eclisia/FrogINTHardware/04_Electronique/FrogINT_PCBProto_V1811062154/Export_Illustration_gros_bouton.png

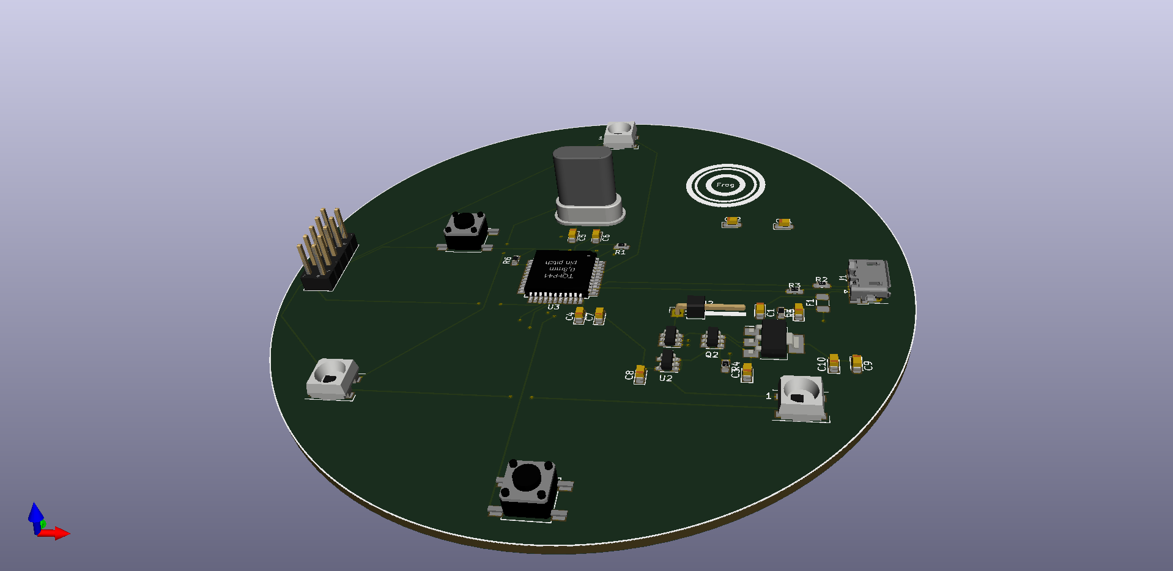
04_Electronique/FrogINT_PCBProto_V1811062154/Export_Illustration_gros_bouton.png
