eclisia/FrogINTHardware/03_Mecanique/FrontFace.png

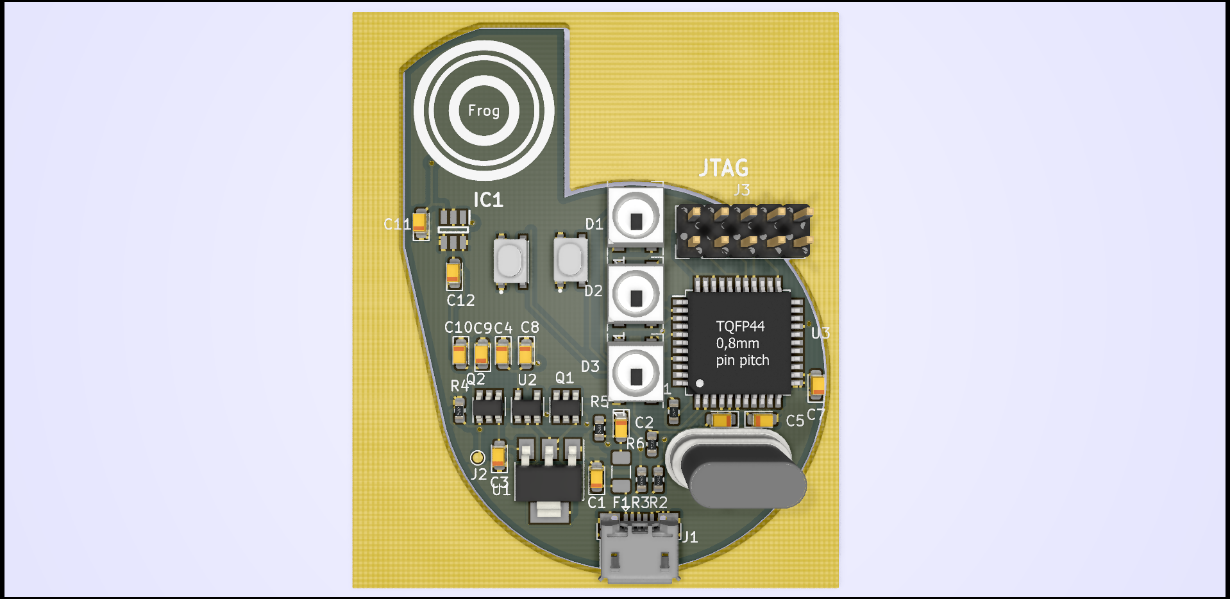
03_Mecanique/FrontFace.png
