eclisia/FrogINTHardware/03_Mecanique/FrontFace_Sans.png

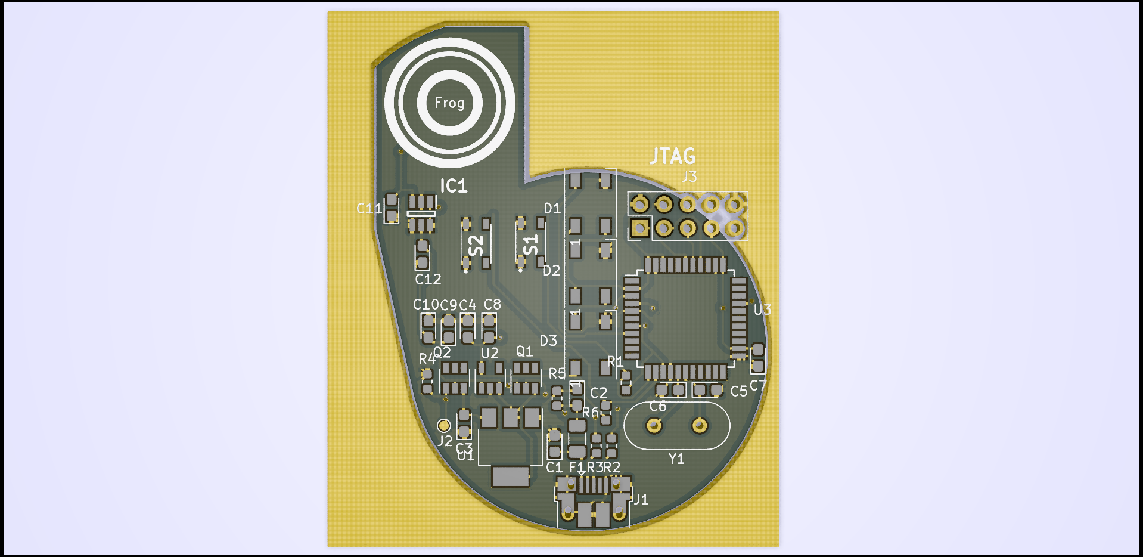
03_Mecanique/FrontFace_Sans.png
