eclisia/FrogINTHardware/03_Mecanique/FrontFace_SVG.png

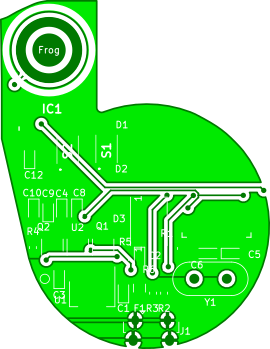
03_Mecanique/FrontFace_SVG.png
