eclisia/FrogINTHardware/04_Electronique/FrogINT_PCBProto_V1811062154/Export_Production_V190118-2315/Illustration_Side2.jpg

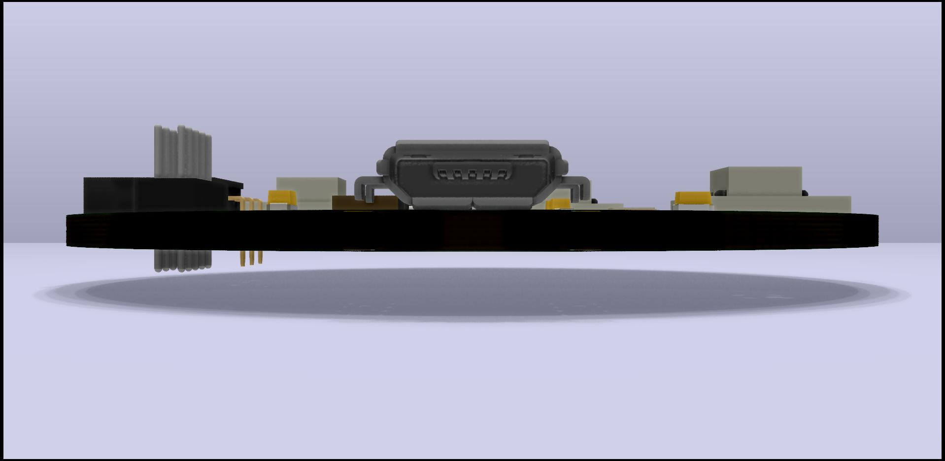
04_Electronique/FrogINT_PCBProto_V1811062154/Export_Production_V190118-2315/Illustration_Side2.jpg
