eclisia/FrogINTHardware/04_Electronique/FrogINT_PCBProto_V1811062154/FrogINT_PCBProto_V1811062154.png

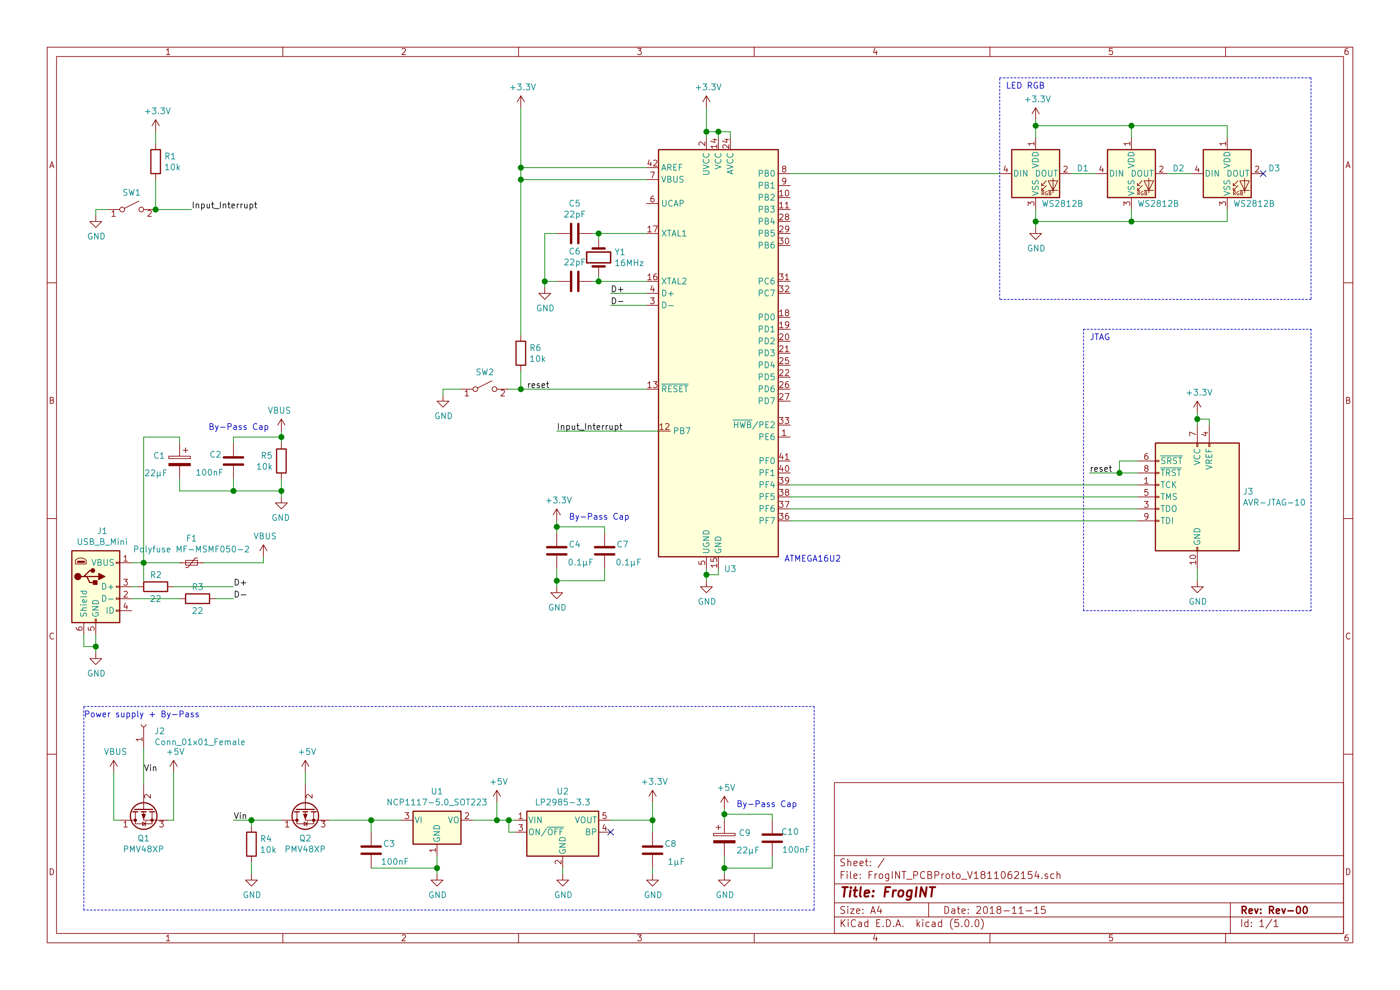
04_Electronique/FrogINT_PCBProto_V1811062154/FrogINT_PCBProto_V1811062154.png
