eclisia/FrogINTHardware/04_Electronique/FrogINT_PCBProto_V1811062154/FrogINT_BOM_V03.xlsx

Sheet: A_Lire
Nouvelle BOM

Sheet: BOM_Format_RS_V3
Version 03 de la BOM
BOM en date du 02/04/2019
BOM issue de la génération via KICAD + fusion avec l'onglet "OLDBOM_format_RS" (de la V2) afin de récupérer les résistances.
Ne sont pas inclus dans cette version :
Tooling pour la réalisation
Valeure différentes de R et C afin de tester le TouchSense
Id | Designator | Package | Quantity | Designation | Réf RadioSpare | Fabricant
1 | G*** | Logo_Thales_Silk_Bottom | 1 | LOGO
2 | G*** | Logo_CCSL_Silk_Bottom | 1 | LOGO
3 | L3,L2,L1 | WS2812-LED_HeatSink | 3 | LED
4 | F1 | FUSC4632X85N | 1 | Polyfuse MF-MSMF050-2 | 647-8156
5 | J1 | 47642-0001_Molex_USB | 1 | USB_B_Mini | 896-7419
6 | Y1 | Crystal_SMD_SeikoEpson_TSX3225-4Pin_3.2x2.5mm_HandSoldering | 1 | XTal TSX-3225 16MHz | 904-7516
7 | C1 | CP_EIA-2012-12_Kemet-R | 1 | 22ÂµF | 838-8083
8 | C2 | CP_EIA-2012-12_Kemet-R | 1 | 100nF | 133-5661
9 | C5,C6,C11 | CP_EIA-2012-12_Kemet-R | 3 | 22pF | 264-4258
10 | J3 | PinSocket_1x03_P2.54mm_Horizontal | 1 | Conn_01x03 | 765-5622
11 | J4 | JTAG_HDRV10W41P127_2X5_676X325X510P | 1 | JTAG | 702-0262P
12 | J5 | TestPoint_THTPad_D2.5mm_Drill1.2mm | 1 | Conn_01x01_Female
13 | R1,R5,R6 | R_0603_1608Metric | 3 | 10k | 120-684
14 | R2,R3 | R_0603_1608Metric | 2 | 22 | 121-889
15 | U3 | TQFP-44_10x10mm_P0.8mm | 1 | ATmega16U4-AU | 177-3649

Sheet: FrogINT_PCBProto_V1811062154
Component,Description,Part,References,Value,Footprint,Quantity Per PCB,Datasheet,Manufacturer_Name,Height,Manufacturer_Part_Number,Mouser Part Number,Mouser Price/Stock,RS Price/Stock,RS Part Number
1,Unpolarized capacitor,C,C4 C7,0.1ÂµF,CP_EIA-2012-12_Kemet-R,2,,,,,,,,
2,Unpolarized capacitor,C,C2 C3 C10 C12,100nF,CP_EIA-2012-12_Kemet-R,4,,,,,,,,
3,Unpolarized capacitor,C,C8,1ÂµF,CP_EIA-2012-12_Kemet-R,1,,,,,,,,
4,Unpolarized capacitor,C,C5 C6 C11,22pF,CP_EIA-2012-12_Kemet-R,3,,,,,,,,
5,Polarized capacitor,CP,C1 C9,22ÂµF,CP_EIA-2012-12_Kemet-R,2,,,,,,,,
6,RGB LED with integrated controller,WS2812B,D1 D2 D3,WS2812B,LED_WS2812B_PLCC4_5.0x5.0mm_P3.2mm,3,https://cdn-shop.adafruit.com/datasheets/WS2812B.pdf,,,,,,,
7,"Resettable fuse, polymeric positive temperature coefficient, small symbol",Polyfuse_Small,F1,Polyfuse MF-MSMF050-2,Fuse_1206_3216Metric,1,,,,,,,,
8,,TTP223-BA6-SamacSys_Parts,IC1,TTP223-BA6,SOT95P285X126-6N,1,https://radiokot.ru/konkursCatDay2014/53/01.pdf,TONTEK,1.26,TTP223-BA6,,,,
9,Atmel 10-pin JTAG connector,AVR-JTAG-10,J3,AVR-JTAG-10,PinHeader_2x05_P2.54mm_Vertical,1,,,,,,,,
10,"Generic connector, single row, 01x01, script generated (kicad-library-utils/schlib/autogen/connector/)",Conn_01x01_Female,J2,Conn_01x01_Female,TestPoint_Pad_D1.0mm,1,,,,,,,,
11,,USB_B_Mini-Connector_FTA,J1,USB_B_Mini,USB_Micro-B_Amphenol_10103594-0001LF_Horizontal,1,,,,,,,,
12,"P-MOSFET transistor, drain/gate/source",Q_PMOS_DGS,Q1 Q2,PMV48XP,SOT-23-6,2,,,,,,,,
13,Resistor,R,R1 R4 R5 R6,10k,R_0603_1608Metric,4,,,,,,,,
14,Resistor,R,R2 R3,22,R_0603_1608Metric,2,,,,,,,,
15,,SKQGAKE010-SamacSys_Parts,S1 S2,SKQGAKE010,SKQGAKE010,2,http://uk.rs-online.com/webdocs/10d6/0900766b810d6137.pdf,ALPS,,SKQGAKE010,688-SKQGAKE010,https://www.mouser.com/Search/Refine.aspx
16,,TouchSense-FTA_FrogINT_library,TS1,TouchSense,CapacitiveTouchSense_Bottom_10mm,1,,,,,,,,
17,,ATmega16U4RC-AU,U3,ATmega16U4RC-AU,TQFP-44_10x10mm_P0.8mm,1,,,,,,,,
18,"150mA 16V Low-noise Low-dropout Regulator With Shutdown, 1.8V output voltage, SOT-23-5",LP2985-3.3,U2,LP2985-3.3,SOT-23-5,1,http://www.ti.com/lit/ds/symlink/lp2985.pdf,,,,,,,
19,"1A Low Dropout regulator, positive, 1.5V fixed output, SOT-223",NCP1117-5.0_SOT223,U1,NCP1117-5.0_SOT223,SOT-223-3_TabPin2,1,http://www.diodes.com/datasheets/AP1117.pdf,,,,,,,
20,Two pin crystal,Crystal,Y1,16MHz,Crystal_HC49-U_Vertical,1,,,,,,,,
Component Groups:,20
Component Count:,35
Fitted Components:,35
Number of PCBs:,1
Total components:,35
Schematic Version:,Rev-00
Schematic Date:,2018-11-15
BoM Date:,21/01/2019 14:16:21
Schematic Source:,D:\Users\taintuf\Documents\04_Travail\04-17_FabLab\01_ConcoursCCSL-Interrompre\02_Electronique\01_Commit_TouchPanel_190116+5a02935\FrogINT_PCBProto_V1811062154\FrogINT_PCBProto_V1811062154.sch
KiCad Version:,Eeschema (5.0.1)-3

Sheet: Mise_en_forme
Component | Description | Part | References | Value | Footprint | Quantity Per PCB | Datasheet | Manufacturer_Name | Height | Manufacturer_Part_Number | Mouser Part Number | Mouser Price/Stock | RS Price/Stock | RS Part Number
1 | Unpolarized capacitor | C | C4 C7 | 0.1ÂµF | CP_EIA-2012-12_Kemet-R | 2
2 | Unpolarized capacitor | C | C2 C3 C10 C12 | 100nF | CP_EIA-2012-12_Kemet-R | 4
3 | Unpolarized capacitor | C | C8 | 1ÂµF | CP_EIA-2012-12_Kemet-R | 1
4 | Unpolarized capacitor | C | C5 C6 C11 | 22pF | CP_EIA-2012-12_Kemet-R | 3
5 | Polarized capacitor | CP | C1 C9 | 22ÂµF | CP_EIA-2012-12_Kemet-R | 2
6 | RGB LED with integrated controller | WS2812B | D1 D2 D3 | WS2812B | LED_WS2812B_PLCC4_5.0x5.0mm_P3.2mm | 3 | https://cdn-shop.adafruit.com/datasheets/WS2812B.pdf
7 | Resettable fuse, polymeric positive temperature coefficient, small symbol | Polyfuse_Small | F1 | Polyfuse MF-MSMF050-2 | Fuse_1206_3216Metric | 1
8 |  | TTP223-BA6-SamacSys_Parts | IC1 | TTP223-BA6 | SOT95P285X126-6N | 1 | https://radiokot.ru/konkursCatDay2014/53/01.pdf | TONTEK | 1.26 | TTP223-BA6
9 | Atmel 10-pin JTAG connector | AVR-JTAG-10 | J3 | AVR-JTAG-10 | PinHeader_2x05_P2.54mm_Vertical | 1
10 | Generic connector, single row, 01x01, script generated (kicad-library-utils/schlib/autogen/connector/) | Conn_01x01_Female | J2 | Conn_01x01_Female | TestPoint_Pad_D1.0mm | 1
11 |  | USB_B_Mini-Connector_FTA | J1 | USB_B_Mini | USB_Micro-B_Amphenol_10103594-0001LF_Horizontal | 1
12 | P-MOSFET transistor, drain/gate/source | Q_PMOS_DGS | Q1 Q2 | PMV48XP | SOT-23-6 | 2
13 | Resistor | R | R1 R4 R5 R6 | 10k | R_0603_1608Metric | 4
14 | Resistor | R | R2 R3 | 22 | R_0603_1608Metric | 2
15 |  | SKQGAKE010-SamacSys_Parts | S1 S2 | SKQGAKE010 | SKQGAKE010 | 2 | http://uk.rs-online.com/webdocs/10d6/0900766b810d6137.pdf | ALPS |  | SKQGAKE010 | 688-SKQGAKE010 | https://www.mouser.com/Search/Refine.aspx?Keyword=688-SKQGAKE010 | http://uk.rs-online.com/web/p/products/7582076P | 7582076P
16 |  | TouchSense-FTA_FrogINT_library | TS1 | TouchSense | CapacitiveTouchSense_Bottom_10mm | 1
17 |  | ATmega16U4RC-AU | U3 | ATmega16U4RC-AU | TQFP-44_10x10mm_P0.8mm | 1
18 | 150mA 16V Low-noise Low-dropout Regulator With Shutdown, 1.8V output voltage, SOT-23-5 | LP2985-3.3 | U2 | LP2985-3.3 | SOT-23-5 | 1 | http://www.ti.com/lit/ds/symlink/lp2985.pdf
19 | 1A Low Dropout regulator, positive, 1.5V fixed output, SOT-223 | NCP1117-5.0_SOT223 | U1 | NCP1117-5.0_SOT223 | SOT-223-3_TabPin2 | 1 | http://www.diodes.com/datasheets/AP1117.pdf
20 | Two pin crystal | Crystal | Y1 | 16MHz | Crystal_HC49-U_Vertical | 1

Sheet: OLDBOM_format_RS
Component | Description | Part | References | Value | Package | Footprint | Quantity Per PCB | RS P/N | MOQ | Prix Unit | Sub-Price | Commentaires et actions PCB | Datasheet | Manufacturer_Name | Height | Manufacturer_Part_Number | Mouser Part Number | Mouser Price/Stock | RS Price/Stock | RS Part Number
1 | Unpolarized capacitor | C | C4 C7 | 0.1ÂµF |  | CP_EIA-2012-12_Kemet-R | 2 | 133-5661 | 100.000 | 0.030 | 3.000
2 | Unpolarized capacitor | C | C2 C3 C10 C12 | 100nF |  | CP_EIA-2012-12_Kemet-R | 4 | 133-5661 |  |  | 0.000 | Doublon de BOM - à confirmer
3 | Unpolarized capacitor | C | C8 | 1ÂµF |  | CP_EIA-2012-12_Kemet-R | 1 | 133-5655 | 150.000 | 0.051 | 7.650
4 | Unpolarized capacitor | C | C5 C6 C11 | 22pF |  | CP_EIA-2012-12_Kemet-R | 3 | 264-4258 | 25.000 | 0.063 | 1.575
5 | Polarized capacitor | CP | C1 C9 | 22ÂµF |  | CP_EIA-2012-12_Kemet-R | 2 | 838-8083 | 25.000 | 0.077 | 1.925 | Empreinte PCB pas la bonne
6 | RGB LED with integrated controller | WS2812B | L3,L2,L1 | WS2812B |  | LED_WS2812B_PLCC4_5.0x5.0mm_P3.2mm | 3 |  |  |  | 0.000 | Appro personnel | https://cdn-shop.adafruit.com/datasheets/WS2812B.pdf
7 | Resettable fuse, polymeric positive temperature coefficient, small symbol | Polyfuse_Small | F1 | Polyfuse MF-MSMF050-2 |  | Fuse_1206_3216Metric | 1 | 647-8156 | 10.000 | 0.417 | 4.170
8 |  | TTP223-BA6-SamacSys_Parts | IC1 | TTP223-BA6 |  | SOT95P285X126-6N | 1 |  |  |  | 0.000 | Non dispo sur RadioSpare | https://radiokot.ru/konkursCatDay2014/53/01.pdf | TONTEK | 1.26 | TTP223-BA6
9 | Atmel 10-pin JTAG connector | AVR-JTAG-10 | J3 | AVR-JTAG-10 |  | 1.27 mm IC Pin Connectors Ø 0.41 mm pin | 1 | 702-0262P | 50.000 | 1.094 | 54.700 |  | https://fr.rs-online.com/web/p/barrettes-pour-ci/7020262P/?searchHistory=%7B%22enabled%22%3Atrue%7D
10 | Generic connector, single row, 01x01, script generated (kicad-library-utils/schlib/autogen/connector/) | Conn_01x01_Female | J2 | Conn_01x01_Female |  | TestPoint_Pad_D1.0mm | 1 |  |  |  | 0.000 | Remplacé par un PAD
11 |  | USB_B_Mini-Connector_FTA | J1 | USB_B_Mini |  | USB_Micro-B_Amphenol_10103594-0001LF_Horizontal | 1 | 896-7419 | 5.000 | 0.606 | 3.030 |  | https://fr.rs-online.com/web/p/connecteurs-micro-usb/8967419/?sra=pmpn
12 | P-MOSFET transistor, drain/gate/source | Q_PMOS_DGS | Q1 Q2 | PMV48XP |  | SOT-23-6 | 2 | 798-2801 | 30.000 | 0.205 | 6.150
13 | Resistor | R | R1 R4 R5 R6 | 10k |  | R_0603_1608Metric | 4 | 120-684 | 100.000 | 0.011 | 1.100
14 | Resistor | R | R2 R3 | 22 |  | R_0603_1608Metric | 2 | 121-889 | 100.000 | 0.011 | 1.100
15 | Bouton | PTS810 SJG 250 SMTR LFS | S1 S2 | PTS810 SJG 250 SMTR LFS |  | PTS810 SJG 250 SMTR LFS | 2 | 135-9492 | 20.000 | 0.285 | 5.700
16 |  | TouchSense-FTA_FrogINT_library | TS1 | TouchSense |  | CapacitiveTouchSense_Bottom_10mm | 1 |  |  |  | 0.000 | PCB
17 |  | ATmega16U4RC-AU | U3 | ATmega16U4RC-AU |  | TQFP-44_10x10mm_P0.8mm | 1 | 177-3649 | 2.000 | 3.615 | 7.230
18 | 150mA 16V Low-noise Low-dropout Regulator With Shutdown, 1.8V output voltage, SOT-23-5 | LP2985-3.3 | U2 | LP2985-3.3 |  | SOT-23-5 | 1 | 660-6733 | 10.000 | 0.737 | 7.370 |  | http://www.ti.com/lit/ds/symlink/lp2985.pdf
19 | 1A Low Dropout regulator, positive, 1.5V fixed output, SOT-223 | NCP1117-5.0_SOT223 | U1 | NCP1117-5.0_SOT223 |  | SOT-223-3_TabPin2 | 1 | 785-7187 | 20.000 | 0.262 | 5.240 |  | http://www.diodes.com/datasheets/AP1117.pdf
20 | 4 pins | Crystal | Y1 | 16MHz |  |  | 1 | 904-7516 | 5.000 | 0.334 | 1.670
 |  |  |  |  |  |  |  |  |  | Total | 111.61 €
 |  |  |  |  |  |  |  |  |  | Nombre de proto réalisable
 |  |  |  |  |  |  |  |  |  |  | 5
 |  |  |  |  |  |  |  |  |  | Soit prix BOM / carte (avec "perte"
 |  |  |  |  |  |  |  |  |  |  | 22.32 €
