eclisia/FrogINTHardware/03_Mecanique/Export_3D_PCB_Illustration-Blender.stl

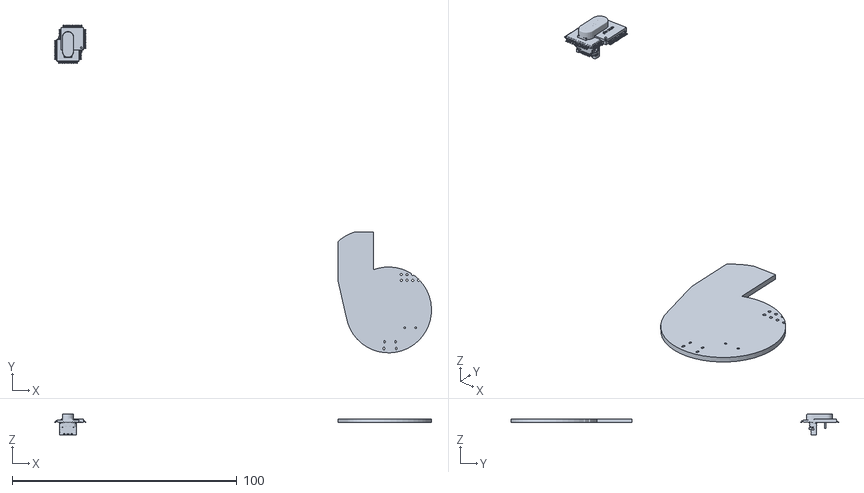
[picture p11: CAD file, 2019-03-14]
03_Mecanique/Export_3D_PCB_Illustration-Blender.stl
167.6 x 145.7 x 9.31
