eclisia/FrogINTHardware/04_Electronique/FrogINT_PCBProto_V1811062154/STD(0805) M(2012).STEP

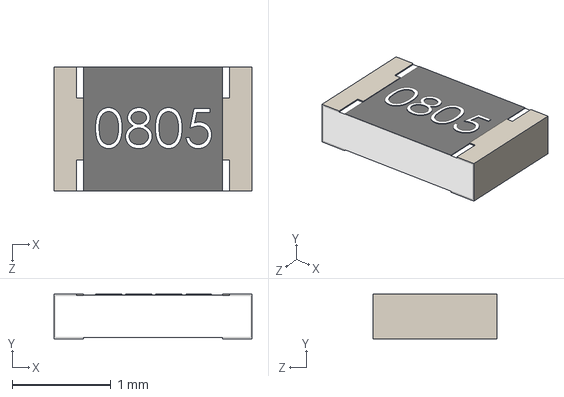
[picture p13: CAD file, 2018-11-27]
04_Electronique/FrogINT_PCBProto_V1811062154/STD(0805) M(2012).STEP
2.00 x 0.45 x 1.25 mm
