eclisia/FrogINTHardware/03_Mecanique/EmpreinteGrenouille_V190205-1621.FCStd

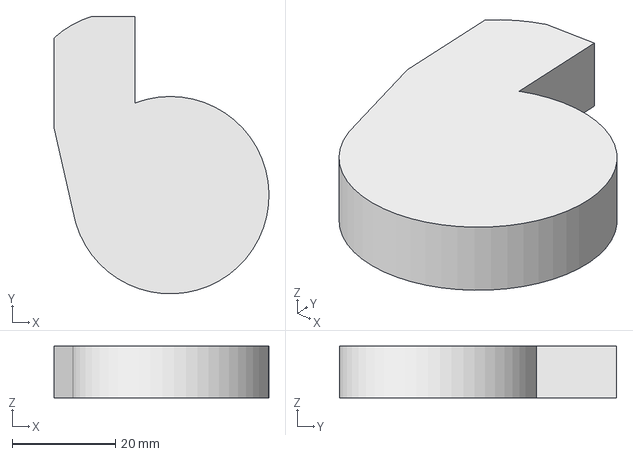
[picture p14: CAD file, 2019-03-14]
03_Mecanique/EmpreinteGrenouille_V190205-1621.FCStd
41.6 x 53.7 x 10.0 mm
