eclisia/FrogINTHardware/04_Electronique/FrogINT_PCBProto_V1811062154/Export_Production_V190118-2315/FrogINT_PCBProto_V1811062154-B_Cu.dxf

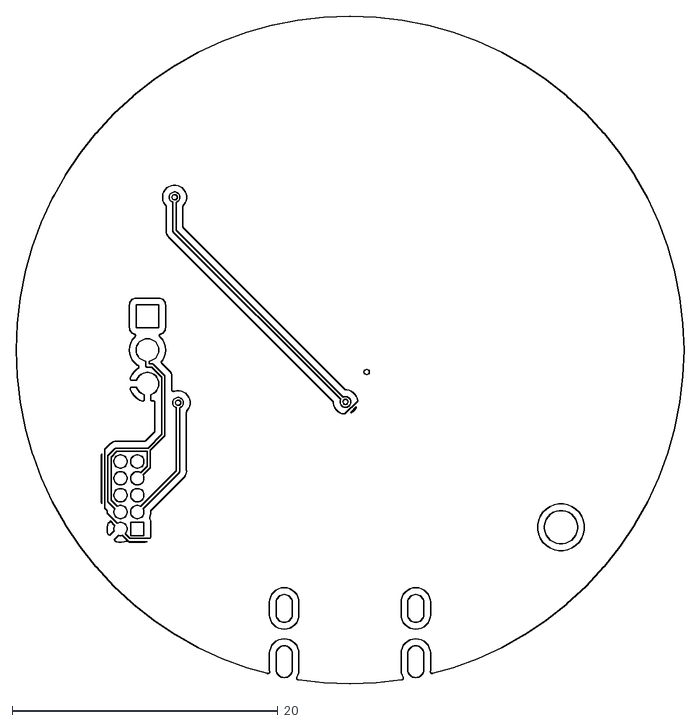
[picture p15: CAD file, 2019-04-02]
04_Electronique/FrogINT_PCBProto_V1811062154/Export_Production_V190118-2315/FrogINT_PCBProto_V1811062154-B_Cu.dxf
50.3 x 50.3
