eclisia/FrogINTHardware/04_Electronique/FrogINT_PCBProto_V1811062154/PZ_PushButton.stp

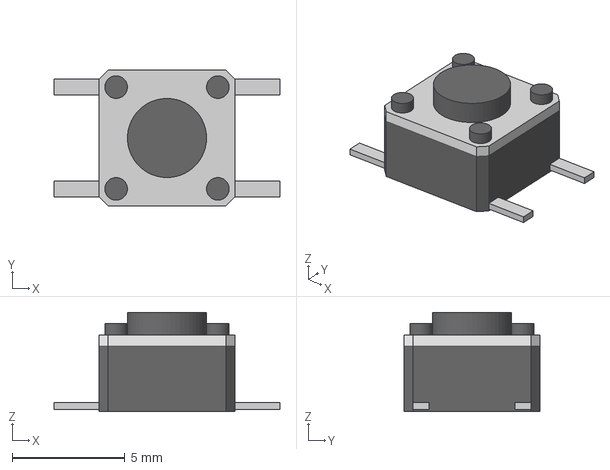
[picture p16: CAD file, 2018-11-27]
04_Electronique/FrogINT_PCBProto_V1811062154/PZ_PushButton.stp
10.0 x 6.00 x 4.40 mm
