eclisia/FrogINTHardware/03_Mecanique/FrogINT_PCBProto_V1811062154-B.Cu.dxf

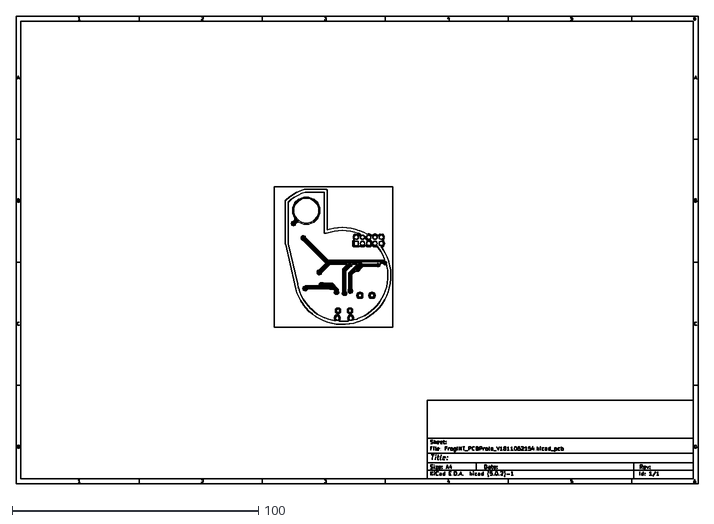
[picture p17: CAD file, 2019-03-14]
03_Mecanique/FrogINT_PCBProto_V1811062154-B.Cu.dxf
277.0 x 190.0
