eclisia/FrogINTHardware/04_Electronique/FrogINT_PCBProto_V1811062154/Export_Production_V190118-2315/FrogINT_PCBProto_V1811062154-Edge_Cuts.dxf

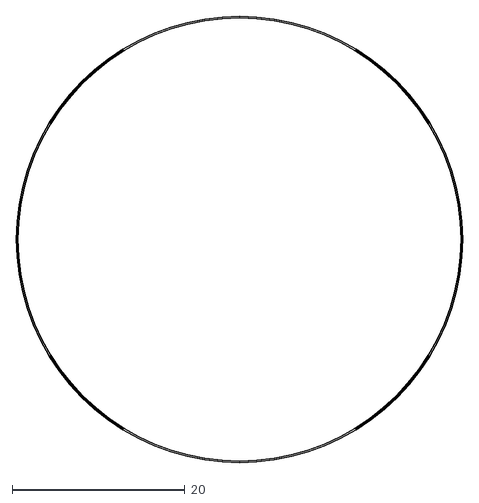
[picture p18: CAD file, 2019-04-02]
04_Electronique/FrogINT_PCBProto_V1811062154/Export_Production_V190118-2315/FrogINT_PCBProto_V1811062154-Edge_Cuts.dxf
51.6 x 51.6
