eclisia/FrogINTHardware/04_Electronique/FrogINT_PCBProto_V1811062154/STD(0201) M(0603).STEP

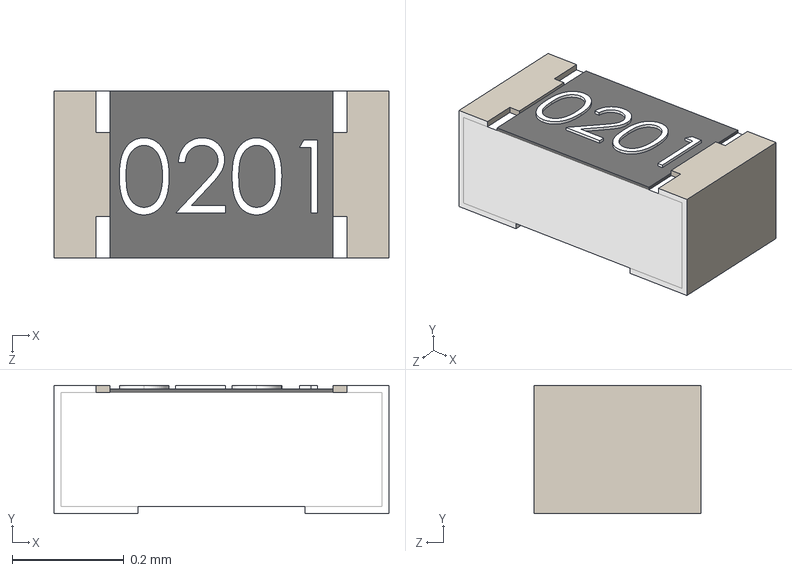
[picture p19: CAD file, 2018-11-27]
04_Electronique/FrogINT_PCBProto_V1811062154/STD(0201) M(0603).STEP
0.6 x 0.23 x 0.3 mm
