eclisia/FrogINTHardware/03_Mecanique/FrogINT_PCBProto_V1811062154-Edge.Cuts.dxf

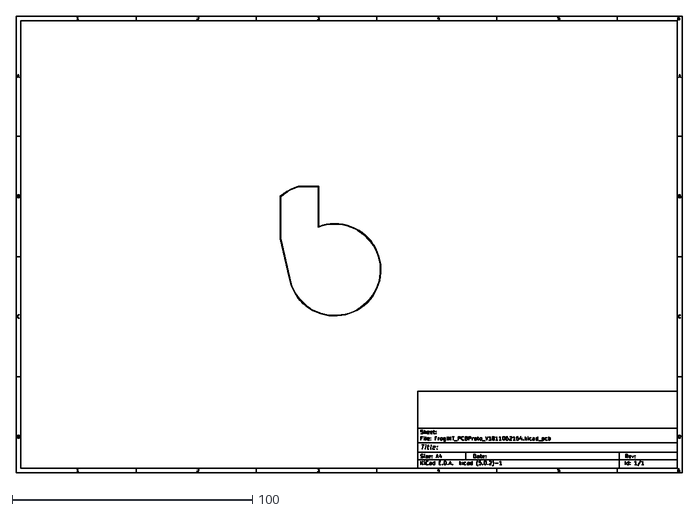
[picture p20: CAD file, 2019-03-14]
03_Mecanique/FrogINT_PCBProto_V1811062154-Edge.Cuts.dxf
277.0 x 190.0
