eclisia/FrogINTHardware/04_Electronique/FrogINT_PCBProto_V1811062154/AB2_USB_MICRO_SMD.stl

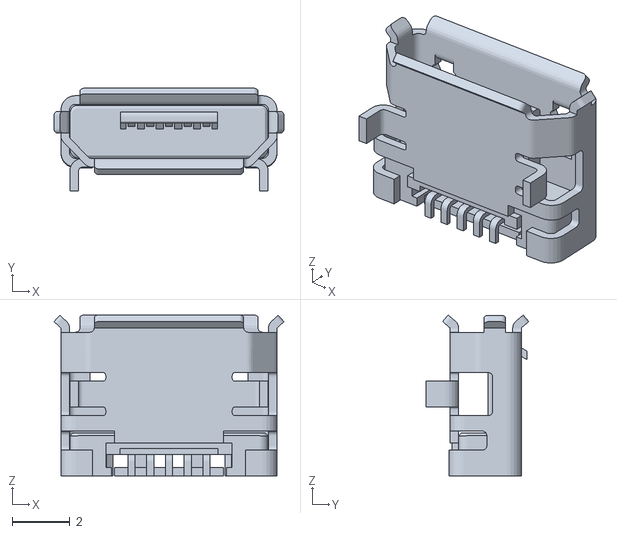
[picture p21: CAD file, 2018-11-27]
04_Electronique/FrogINT_PCBProto_V1811062154/AB2_USB_MICRO_SMD.stl
8.00 x 3.57 x 5.60
