eclisia/FrogINTHardware/03_Mecanique/FrogINT_PCBProto_V1811062154-F.Cu.dxf

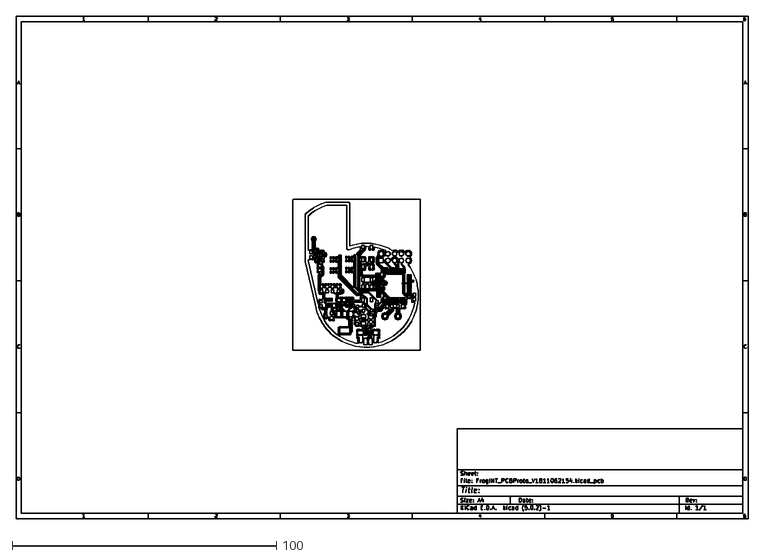
[picture p23: CAD file, 2019-03-14]
03_Mecanique/FrogINT_PCBProto_V1811062154-F.Cu.dxf
277.0 x 190.0
