eclisia/FrogINTHardware/04_Electronique/FrogINT_PCBProto_V1811062154/TQFP44.stp

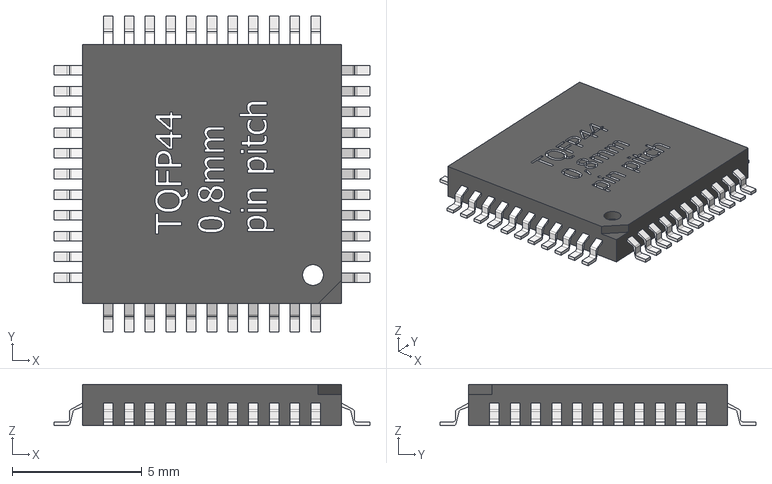
[picture p24: CAD file, 2018-11-27]
04_Electronique/FrogINT_PCBProto_V1811062154/TQFP44.stp
12.2 x 12.2 x 1.60 mm
