eclisia/FrogINTHardware/03_Mecanique/Empreinte_Switch.FCStd

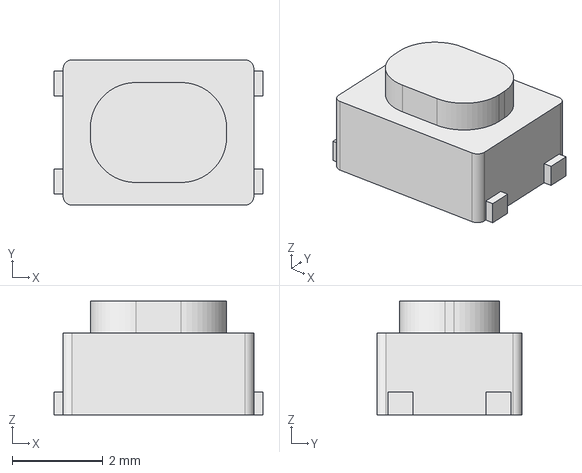
[picture p25: CAD file, 2019-03-14]
03_Mecanique/Empreinte_Switch.FCStd
4.60 x 3.20 x 2.50 mm
