eclisia/FrogINTHardware/04_Electronique/FrogINT_PCBProto_V1811062154/XTAL.stp

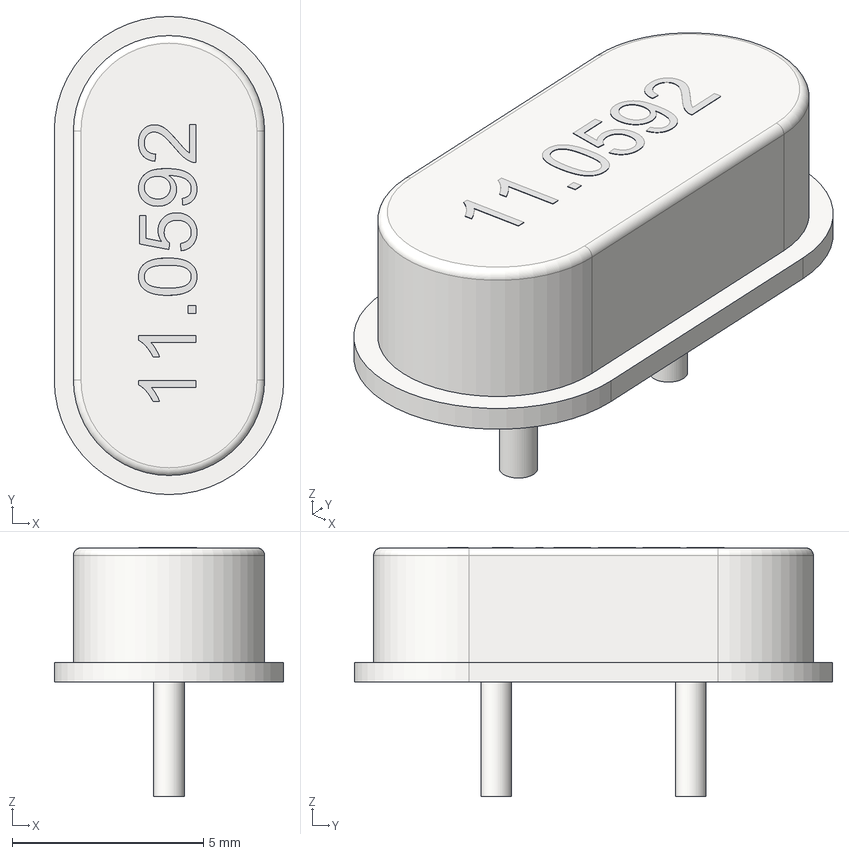
[picture p26: CAD file, 2018-11-27]
04_Electronique/FrogINT_PCBProto_V1811062154/XTAL.stp
6.00 x 12.5 x 6.51 mm
