eclisia/FrogINTHardware/04_Electronique/FrogINT_PCBProto_V1811062154/STD(1206) M(3216).STEP

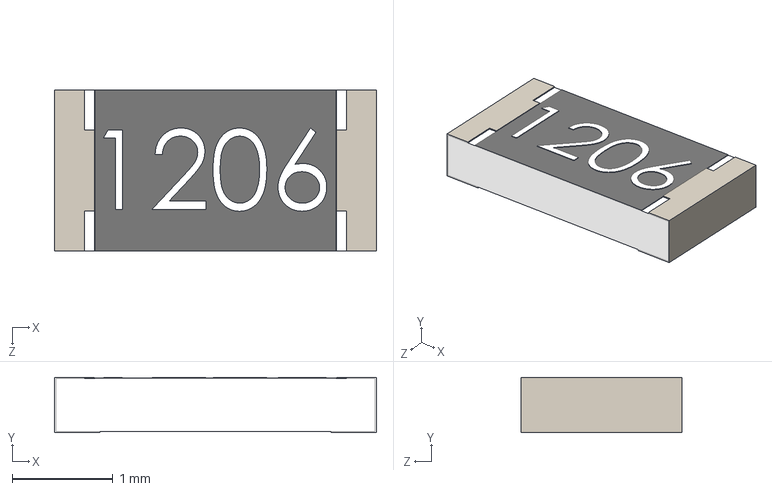
[picture p27: CAD file, 2018-11-27]
04_Electronique/FrogINT_PCBProto_V1811062154/STD(1206) M(3216).STEP
3.20 x 0.55 x 1.60 mm
