eclisia/FrogINTHardware/04_Electronique/FrogINT_PCBProto_V1811062154/JTAG-Header_2-54_2x5.stl

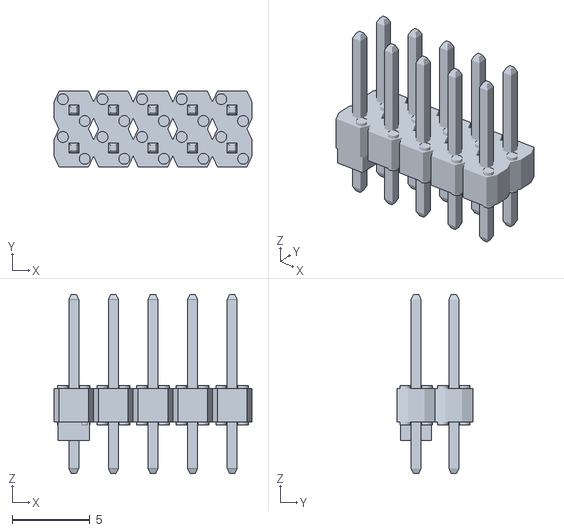
[picture p28: CAD file, 2018-11-27]
04_Electronique/FrogINT_PCBProto_V1811062154/JTAG-Header_2-54_2x5.stl
12.7 x 4.85 x 11.5
