eclisia/FrogINTHardware/03_Mecanique/FrogINT_Layout.dxf

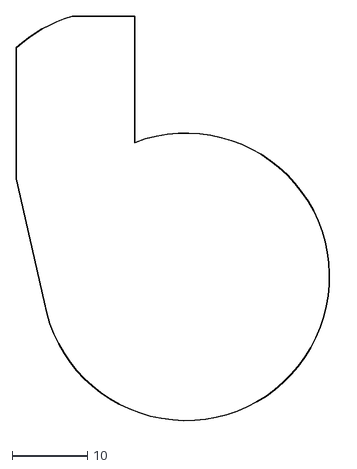
[picture p29: CAD file, 2019-03-14]
03_Mecanique/FrogINT_Layout.dxf
43.1 x 54.8
