eclisia/FrogINTHardware/04_Electronique/FrogINT_PCBProto_V1811062154/AB2_HDR_M01-1V_WINGS3D.stl

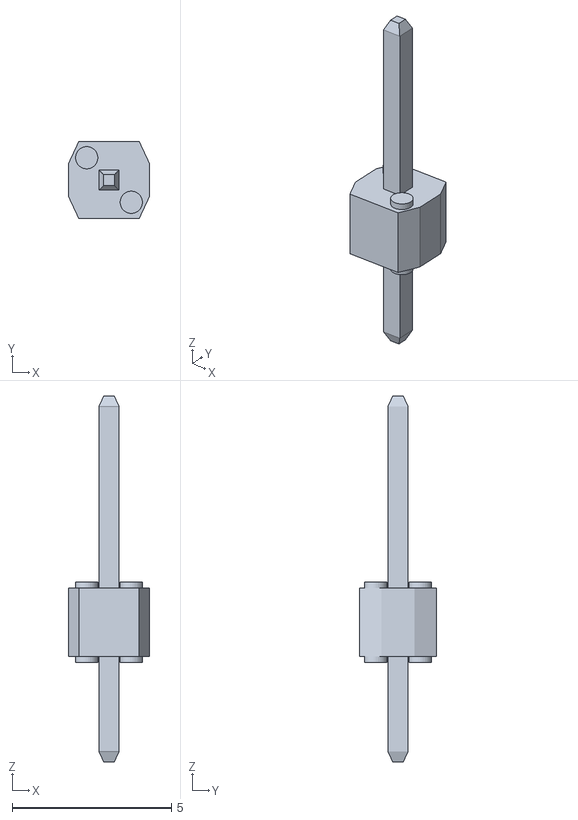
[picture p30: CAD file, 2018-11-27]
04_Electronique/FrogINT_PCBProto_V1811062154/AB2_HDR_M01-1V_WINGS3D.stl
2.54 x 2.42 x 11.5
