eclisia/FrogINTHardware/04_Electronique/FrogINT_PCBProto_V1811062154/STD(0603) M(1608).STEP

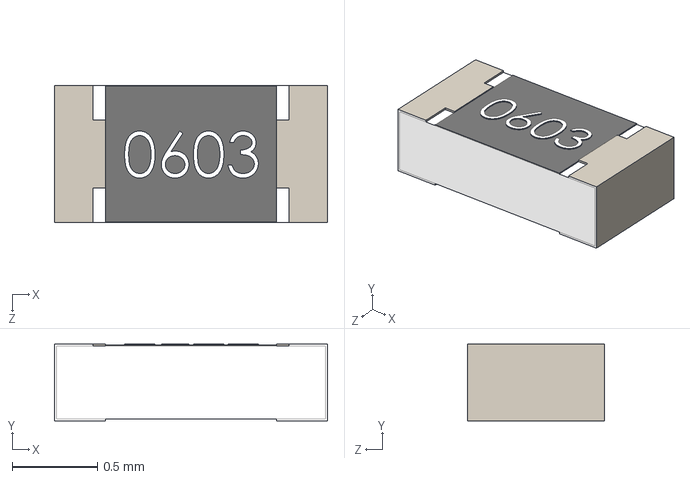
[picture p31: CAD file, 2018-11-27]
04_Electronique/FrogINT_PCBProto_V1811062154/STD(0603) M(1608).STEP
1.60 x 0.45 x 0.8 mm
