eclisia/FrogINTHardware/04_Electronique/FrogINT_PCBProto_V1811062154/SMD WS2812B Mini.step

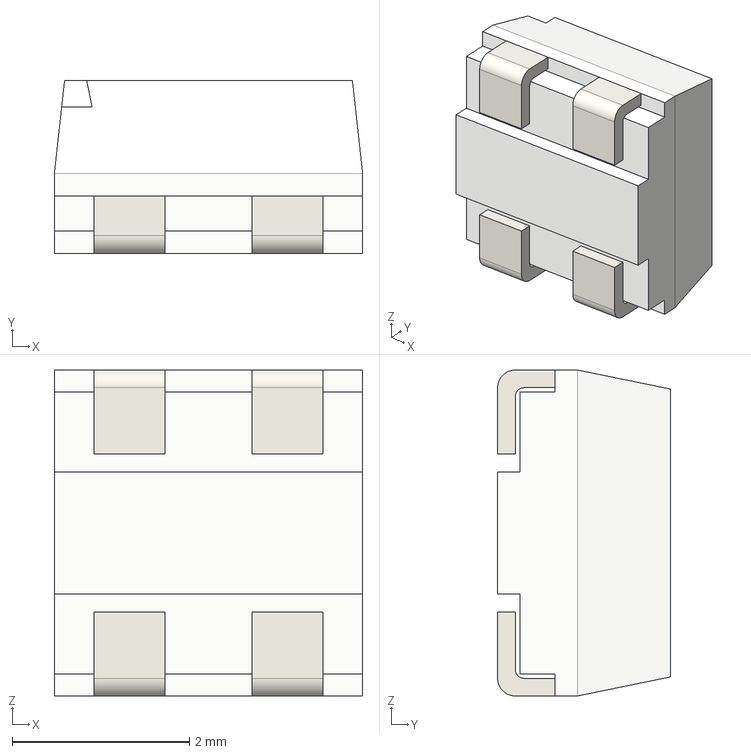
[picture p32: CAD file, 2018-11-27]
04_Electronique/FrogINT_PCBProto_V1811062154/SMD WS2812B Mini.step
3.48 x 1.95 x 3.68 mm
