eclisia/FrogINTHardware/04_Electronique/FrogINT_PCBProto_V1811062154/STD(0402) M(1005).STEP

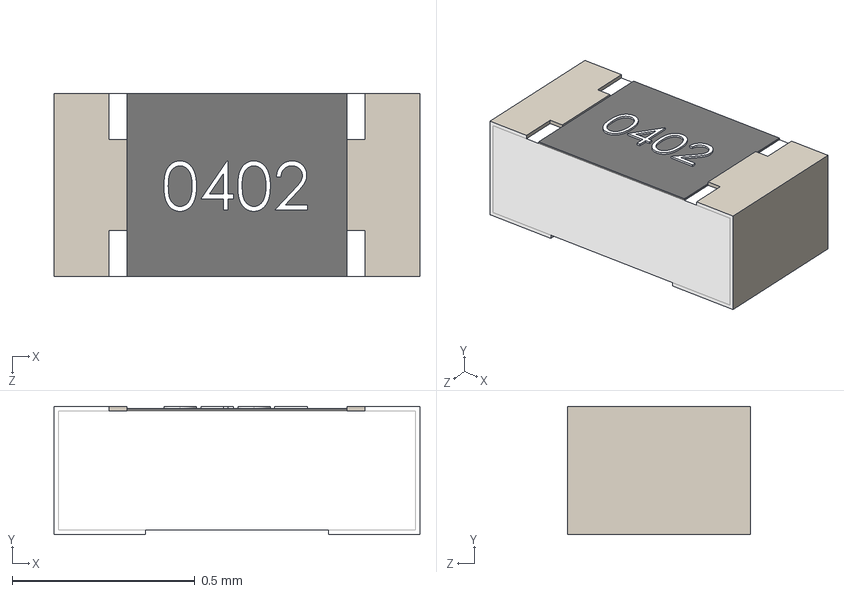
[picture p33: CAD file, 2018-11-27]
04_Electronique/FrogINT_PCBProto_V1811062154/STD(0402) M(1005).STEP
1.00 x 0.35 x 0.5 mm
