eclisia/FrogINTHardware/(list of files, cad)

Other CAD files:
03_Mecanique/Empreinte_Switch_PTS810SJG250SMTRLFS.FCStd
03_Mecanique/PTS810SJG250SMTRLFS.step
03_Mecanique/FrogINT_PCBProto_V1811062154-B.Mask.dxf
03_Mecanique/FrogINT_PCBProto_V1811062154-B.Paste.dxf
03_Mecanique/FrogINT_PCBProto_V1811062154-B.SilkS.dxf
03_Mecanique/FrogINT_PCBProto_V1811062154-F.Mask.dxf
03_Mecanique/FrogINT_PCBProto_V1811062154-F.Paste.dxf
03_Mecanique/FrogINT_PCBProto_V1811062154-F.SilkS.dxf
04_Electronique/FrogINT_PCBProto_V1811062154/Export_Production_V190118-2315/FrogINT_PCBProto_V1811062154-B_Mask.dxf
04_Electronique/FrogINT_PCBProto_V1811062154/Export_Production_V190118-2315/FrogINT_PCBProto_V1811062154-B_Paste.dxf
04_Electronique/FrogINT_PCBProto_V1811062154/Export_Production_V190118-2315/FrogINT_PCBProto_V1811062154-B_SilkS.dxf
04_Electronique/FrogINT_PCBProto_V1811062154/Export_Production_V190118-2315/FrogINT_PCBProto_V1811062154-F_Mask.dxf
04_Electronique/FrogINT_PCBProto_V1811062154/Export_Production_V190118-2315/FrogINT_PCBProto_V1811062154-F_Paste.dxf
04_Electronique/FrogINT_PCBProto_V1811062154/Export_Production_V190118-2315/FrogINT_PCBProto_V1811062154-F_SilkS.dxf
