eclisia/FrogINTHardware/04_Electronique/FrogINT_PCBProto_V1811062154/FrogINT_PCBProto_V1811062154.pdf

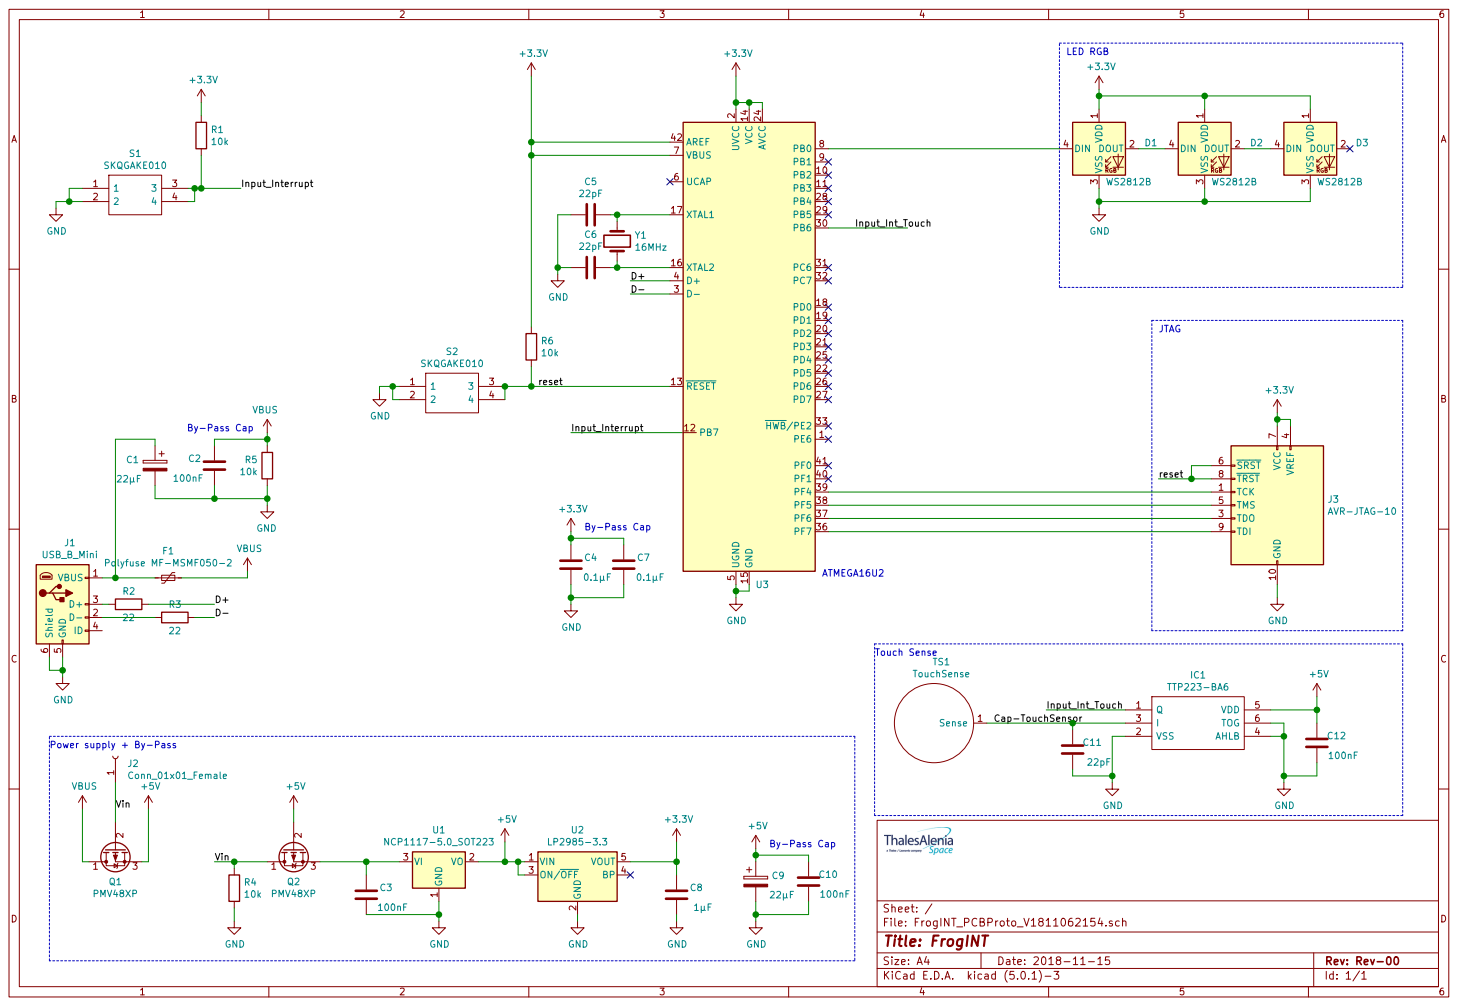
[picture p34: page 1]

2 PD2 20 PD3 21 PD5 22 AVCC 24 PD4 25 PD6 26 PD7 27 PB4 28 PB5 29 D- 3 PB6 30 PC6 31 PC7 32 HWB/PE2 33 PF7 36 PF6 37 PF5 38 PF4 39 D+ 4 PF1 40 PF0 41 AREF 42 UGND

By-Pass Cap GND

J2Conn_01x01_Female Vin Power supply + By-Pass R2

Touch Sense Sense 1 TS1 TouchSense

1 VO 2 VI 3 U1 NCP1117-5.0_SOT223 VIN 1 GND

2 ON/OFF 3 BP 4 VOUT 5 U2

By-Pass Cap +5V GND
