eclisia/FrogINTHardware/(list of files, drawings)

Other design files:
04_Electronique/FrogINT_PCBProto_V1811062154/FrogINT_PCBProto_V1811062154.dsn
04_Electronique/FrogINT_PCBProto_V1811062154/FrogINT_PCBProto_V1811062154_Push_To_be_routed.dsn
04_Electronique/FrogINT_PCBProto_V1811062154/FrogINT_PCBProto_V1811062154_Routed.dsn
