eclisia/FrogINTHardware/04_Electronique/FrogINT_PCBProto_V1811062154/FrogINT_PCBProto_V1811062154.kicad_pcb

## KiCad design 04_Electronique/FrogINT_PCBProto_V1811062154/FrogINT_PCBProto_V1811062154.kicad_pcb (2019-04-02)

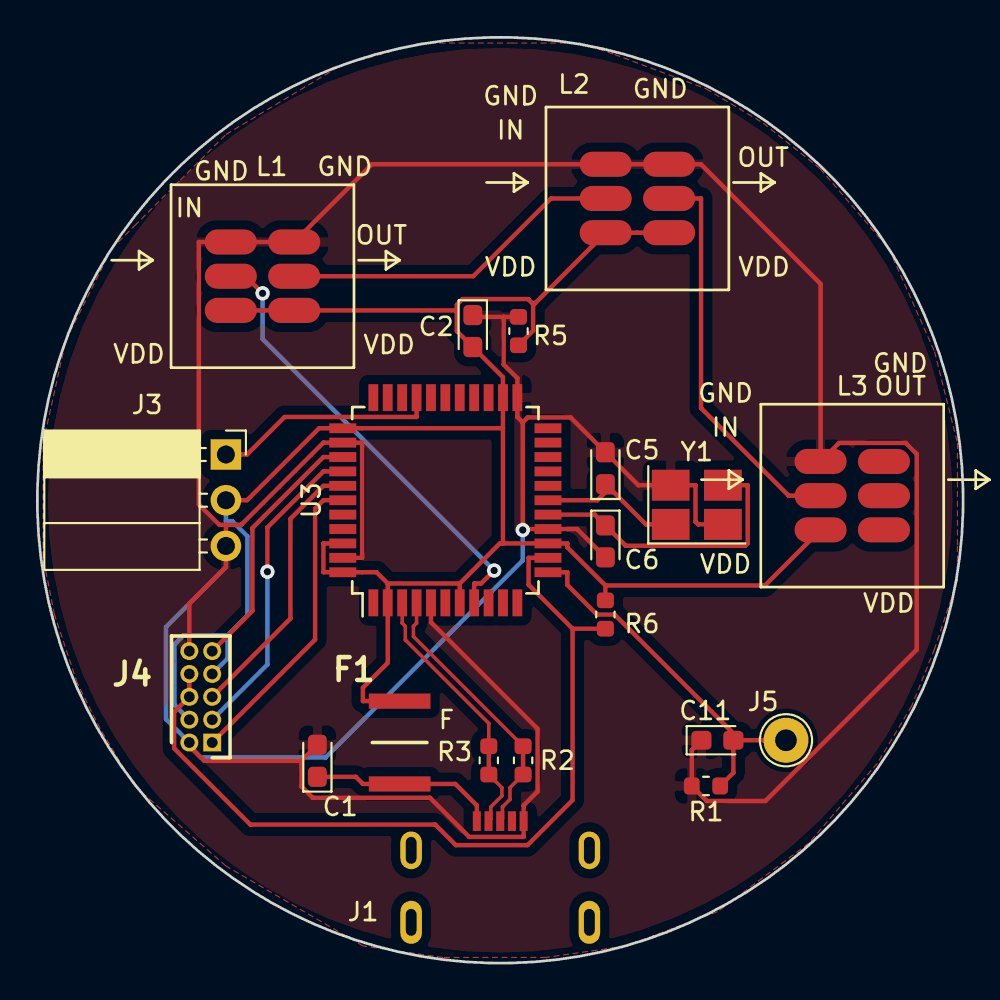
[picture p52: board FrogINT_PCBProto_V1811062154.kicad_pcb from above]

Board: 2 copper layers, 51.4 x 51.4 mm, 20 parts (0 on the bottom side), 17 nets.

Parts:
C1: 22µF; CP_EIA-2012-12_Kemet-R
C2: 100nF; CP_EIA-2012-12_Kemet-R
C5, C6, C11: 22pF; CP_EIA-2012-12_Kemet-R
F1: Polyfuse MF-MSMF050-2; FUSC4632X85N
J1: USB_B_Mini; 47642-0001_Molex_USB
J3: Conn_01x03; PinSocket_1x03_P2.54mm_Horizontal
J4: JTAG; JTAG_HDRV10W41P127_2X5_676X325X510P
J5: Conn_01x01_Female; TestPoint_THTPad_D2.5mm_Drill1.2mm
L1, L2, L3: LED; WS2812-LED_HeatSink
R1, R5, R6: 10k; R_0603_1608Metric
R2, R3: 22; R_0603_1608Metric
U3: ATmega16U4-AU; TQFP-44_10x10mm_P0.8mm
Y1: XTal TSX-3225 16MHz; Crystal_SMD_SeikoEpson_TSX3225-4Pin_3.2x2.5mm_HandSoldering

Connections:
+3V3: C2.2, F1.1, J3.2, J4.4, J4.7, L1.3, L1.6, L2.3, L2.6, L3.3, R5.1, R6.1, U3.2, U3.7, U3.14, U3.24, U3.34, U3.42, U3.44
/D+: J1.3, R2.1, R2.2, U3.4
/D-: J1.2, R3.1, R3.2, U3.3
/Input_Int_Touch: J3.1, U3.30
/Input_Interrupt: C11.2, J5.1, R1.1, U3.12
/reset: J4.6, J4.8, R6.2, U3.13
GND: C1.2, C2.1, C5.2, C6.2, C11.1, J1.5, J3.3, J4.2, J4.10, L1.1, L1.4, L2.1, L2.4, L3.1, R1.2, R5.2, U3.5, U3.15, U3.23, U3.35, U3.43, Y1.2, Y1.4
unnamed: C1.1, F1.2, J1.1
unnamed: C5.1, U3.17, Y1.1
unnamed: C6.1, U3.16, Y1.3
unnamed: J4.1, U3.39
unnamed: J4.3, U3.37
unnamed: J4.5, U3.38
unnamed: J4.9, U3.36
unnamed: L1.2, U3.8
unnamed: L1.5, L2.2
unnamed: L2.5, L3.2
