eclisia/FrogINTHardware/04_Electronique/FrogINT_PCBProto_V1811062154/FrogINT_PCBProto_V1811062154_Push.kicad_pcb

## KiCad design 04_Electronique/FrogINT_PCBProto_V1811062154/FrogINT_PCBProto_V1811062154_Push.kicad_pcb (2018-11-28)

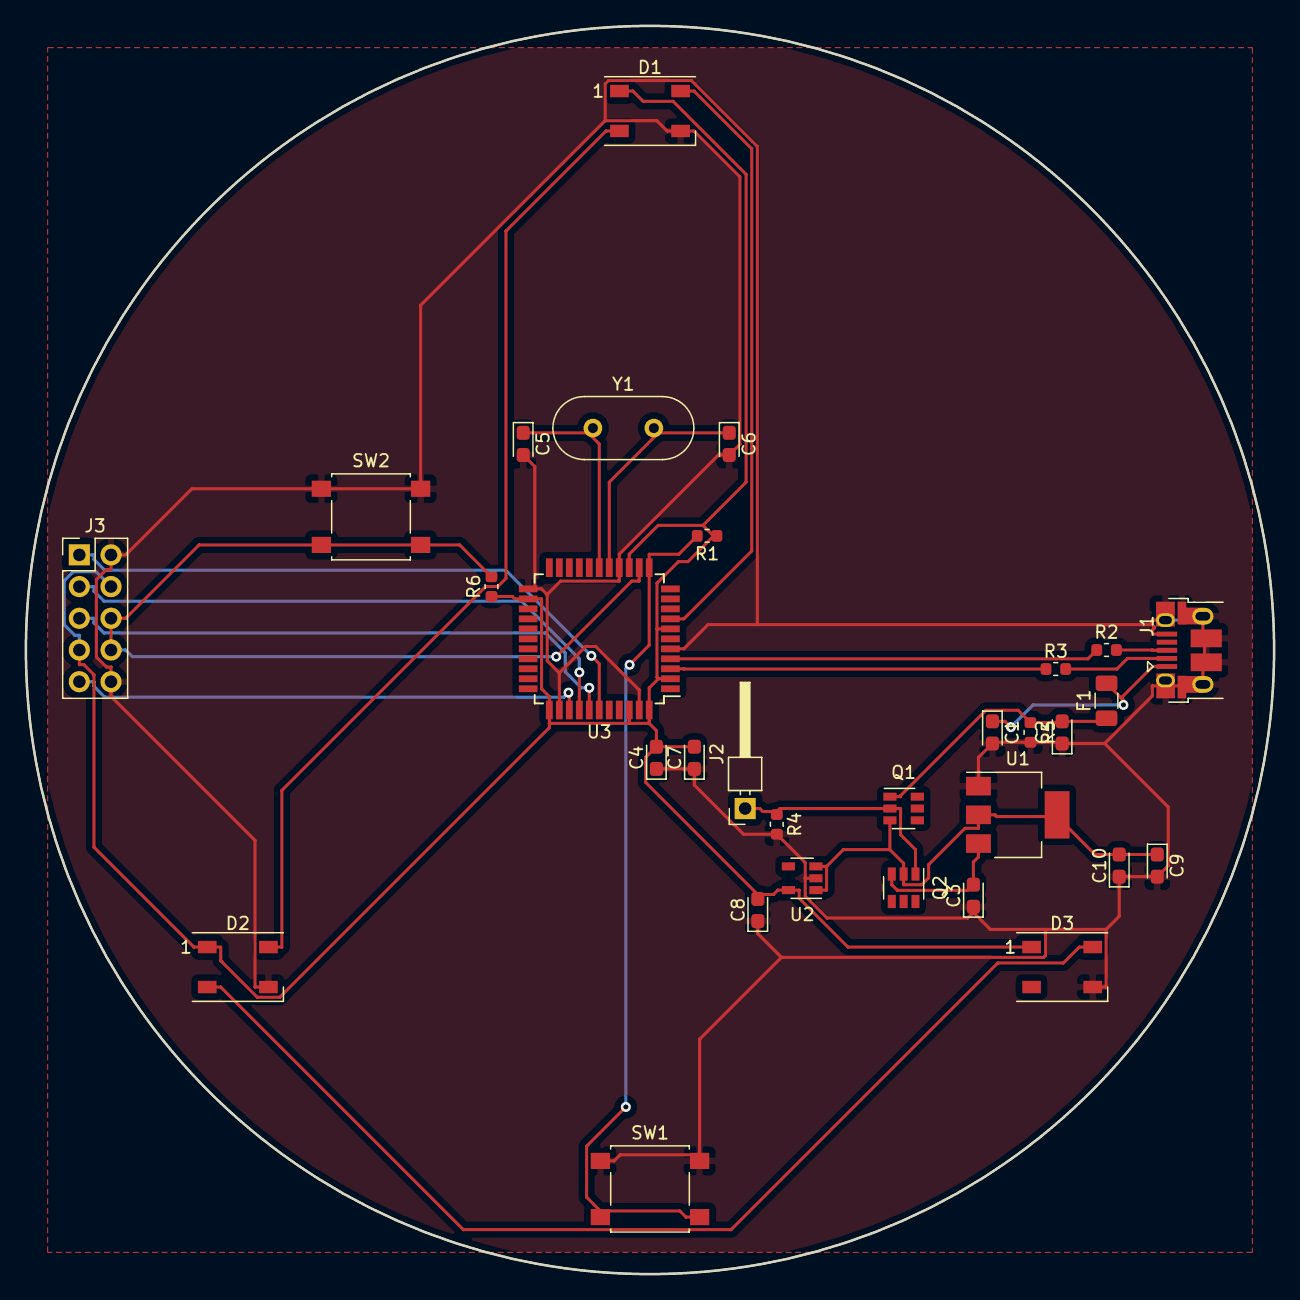
[picture p53: board FrogINT_PCBProto_V1811062154_Push.kicad_pcb from above]

Board: 2 copper layers, 100.0 x 100.0 mm, 31 parts (0 on the bottom side), 22 nets.

Parts:
C1, C9: 22µF; CP_EIA-2012-12_Kemet-R
C2, C3, C10: 100nF; CP_EIA-2012-12_Kemet-R
C4, C7: 0.1µF; CP_EIA-2012-12_Kemet-R
C5, C6: 22pF; CP_EIA-2012-12_Kemet-R
C8: 1µF; CP_EIA-2012-12_Kemet-R
D1, D2, D3: WS2812B; LED_WS2812B_PLCC4_5.0x5.0mm_P3.2mm
F1: Polyfuse MF-MSMF050-2; Fuse_1206_3216Metric
J1: USB_B_Mini; USB_Micro-B_Amphenol_10103594-0001LF_Horizontal
J2: Conn_01x01_Female; PinHeader_1x01_P2.54mm_Horizontal
J3: AVR-JTAG-10; PinHeader_2x05_P2.54mm_Vertical
Q1, Q2: PMV48XP; SOT-23-6
R1, R4, R5, R6: 10k; R_0603_1608Metric
R2, R3: 22; R_0603_1608Metric
SW1, SW2: SW_SPST; SW_SPST_B3S-1000
U1: NCP1117-5.0_SOT223; SOT-223-3_TabPin2
U2: LP2985-3.3; SOT-23-5
U3: ATmega16U4RC-AU; TQFP-44_10x10mm_P0.8mm
Y1: 16MHz; Crystal_HC49-U_Vertical

Connections:
+3V3: C4.2, C7.2, C8.2, D1.1, D2.1, D3.1, J3.4, J3.7, R1.1, R6.1, U2.5, U3.2, U3.7, U3.14, U3.24, U3.34, U3.42, U3.44
+5V: C9.1, C10.2, Q1.3, Q2.2, U1.2, U2.1, U2.3
/D+: R2.1, U3.4
/D-: R3.1, U3.3
/Input_Interrupt: R1.2, SW1.2, U3.12
/Vin: J2.1, Q1.2, Q2.1, R4.1
/reset: J3.6, J3.8, R6.2, SW2.2, U3.13
GND: C1.2, C2.1, C3.1, C4.1, C5.2, C6.2, C7.1, C8.1, C9.2, C10.1, D1.3, D2.3, D3.3, J1.5, J1.6, J3.2, J3.10, R4.2, R5.2, SW1.1, SW2.1, U1.1, U2.2, U3.5, U3.15, U3.23, U3.35, U3.43
unnamed: C1.1, F1.2, J1.1
unnamed: C3.2, Q2.3, U1.3
unnamed: C5.1, U3.17, Y1.1
unnamed: C6.1, U3.16, Y1.2
unnamed: D1.2, D2.4
unnamed: D1.4, U3.8
unnamed: D2.2, D3.4
unnamed: J1.2, R3.2
unnamed: J1.3, R2.2
unnamed: J3.1, U3.39
unnamed: J3.3, U3.37
unnamed: J3.5, U3.38
unnamed: J3.9, U3.36
VBUS: C2.2, F1.1, Q1.1, R5.1
