eclisia/FrogINTHardware/(commit log)

2018-11-06 FirstCommit with Kicad project and files creation
    [FrogINT_PCBProto_V1811062154.kicad_pcb, FrogINT_PCBProto_V1811062154.sch]
2018-11-06 Ajout de documentation de référence - design Lilypad Arduino
2018-11-06 Modification librairie AVR ATmega16U4-AU pour obtenir un symbol personnalisé avec réorganisation des pins pour meilleures clareté dans le schéma.
    Création d'une carte MindMap pour ordonner les idées.
    [FrogINT_PCBProto_V1811062154.sch]
2018-11-12 Creation d'une version Draft du schéma
    [FrogINT_PCBProto_V1811062154.sch]
2018-11-17 Création version 01 du schéma pour impression Chine
    [FrogINT_PCBProto_V1811062154.sch]
2018-11-27 First Prototype realization concerning the PCB, BOM and other manufacturing files.
    This prototype could be use with Chinese partner for "Request For Quotation" process.
    [AB2_HDR_M01-1V_WINGS3D.stl, AB2_USB_MICRO_SMD.stl, FrogINT_PCBProto_V1811062154.csv, FrogINT_PCBProto_V1811062154.kicad_pcb, FrogINT_PCBProto_V1811062154.sch, FrogINT_PCBProto_V1811062154_BOM.xlsx, FrogINT_PCBProto_V1811062154_Recovery.kicad_pcb, JTAG-Header_2-54_2x5.stl]
2018-11-27 Finalisation du routage + création d'un nouveau routage "Push" pour tester une nouvelle implémentation + Ajout d'un Logo en silkscreen & Copper.
    [FrogINT_PCBProto_V1811062154.kicad_pcb, FrogINT_PCBProto_V1811062154_Push.kicad_pcb]
2018-11-28 Ajout d'un Logo-FrogINT en tant qu'Image et que module pour l'inclure sur le PCB et SilkScreen
    Ajout d'une version "Push" du PCB avec l'utilisation de Freerouting - autoroutage.
    [FrogINT_PCBProto_V1811062154_Push.kicad_pcb, FrogINT_PCBProto_V1811062154_Push_To_be_routed.dsn]
2019-01-07 Creation d'un touch Pad et Ajout du composant TTP223.
    Création des librairies équivalentes pour le pad dans Samsac.
    [FrogINT_PCBProto_V1811062154.kicad_pcb, FrogINT_PCBProto_V1811062154.sch]
2019-01-14 ***Commit du 14/01/2019 suite aux modifications du 11/01/2019
    • Création d'un nouveau composant (schéma + PCB) TouchSense sur la librairie FTA (et non plus Samacsys)
    • Ajout de ce composant dans le design courant
    [FrogINT_PCBProto_V1811062154.kicad_pcb, FrogINT_PCBProto_V1811062154.sch]
2019-01-14 ***Commit du 14/01/2019 :
    - Mise à jour des micro switch - choix d'une référence plus petites.
    - Mise à jour des librairies
    - Ajout des librairies SamacSys directement dans le projet
    [FrogINT_PCBProto_V1811062154.kicad_pcb, FrogINT_PCBProto_V1811062154.sch]
2019-01-22 Commit 22/01/2019 : Version 03 de la BOM + Intégration 100% du PCB pour réalisation chiffrage
    Mise à jour des librairies et des chemins relatifs des librairies de composants
    Remplacement du Point de Contrôle type pin header FE 2.54mm par un PAD sur le PCB
    Ajout des sérigraphies définitives.
    [FrogINT_PCBProto_V1811062154-B.Cu.gbl, FrogINT_PCBProto_V1811062154-B.Mask.gbs, FrogINT_PCBProto_V1811062154-B.Paste.gbp, FrogINT_PCBProto_V1811062154-B.SilkS.gbo, FrogINT_PCBProto_V1811062154-Edge.Cuts.gm1, FrogINT_PCBProto_V1811062154-F.Cu.gtl, FrogINT_PCBProto_V1811062154-F.Mask.gts, FrogINT_PCBProto_V1811062154-F.Paste.gtp]
2019-01-28 HotFix : Erreur du précédent commit car tous les fichiers ont été cryptés.
    [FrogINT_BOM_V03-Commit-22-01-2019_RFQ_RS.xlsx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]
2019-02-05 Commit du 05/02/2019 :
    Création d'une nouvelle forme de PCB,
    Placement sommaire des composants,
    Utilisation de Freerouting.jar pour effectuer une partie du routage.
    [EmpreinteGrenouille_V190205-1621.FCStd, FrogINT_Layout.dxf, FrogINT_PCBProto_V1811062154.dsn, FrogINT_PCBProto_V1811062154.kicad_pcb]
2019-02-12 12/02/2019 : Remplacement des gros boutons par des plus petits
    Impact :
    Mise à jour du fichier Excel FrogINT_BOM_V03-Commit-22-01-2019_RFQ_RS.xlsx suite à la mise à jour de la BOM (Attention pour les chiffrage en cours)
    Création des fichiers sources mécaniques pour ce nouveau Switch_PTS810SJG250SMTRLFS
    Mise à jour des références des librairies (pointeur).
    Déplacement partiel de la librairie SamacSys_Parts directement dans la "racine" du projet (et non plus dans l'arborescence C: etc.)
    [Empreinte_Switch.FCStd, Empreinte_Switch_PTS810SJG250SMTRLFS.FCStd, FrogINT_BOM_V03-Commit-22-01-2019_RFQ_RS.xlsx, FrogINT_PCBProto_V1811062154.kicad_pcb, FrogINT_PCBProto_V1811062154.sch, PTS810SJG250SMTRLFS.step]
2019-02-26 26/02/2019 : Déplacement de la librairie SamacSys dans le répertoire du projet.
2019-03-12 Modification mineur pour réaliser des exports graphiques uniquement.
    [Export_3D_PCB_Illustration-Blender.stl, FrogINT_PCBProto_V1811062154-B.Cu.dxf, FrogINT_PCBProto_V1811062154-B.Mask.dxf, FrogINT_PCBProto_V1811062154-B.Paste.dxf, FrogINT_PCBProto_V1811062154-B.SilkS.dxf, FrogINT_PCBProto_V1811062154-Edge.Cuts.dxf, FrogINT_PCBProto_V1811062154-F.Cu.dxf, FrogINT_PCBProto_V1811062154-F.Mask.dxf]
2019-03-14 Creation d'une archive avec la version initiale de la BOM. La future version apportera des changements majeurs.
2019-03-14 Commit du 14/03/2019 :
    - Remplacement header JTAG 2.54 par un header au format 1.27 afin de réduire taille sur le PCB
    - Suppression des composants ainsi que du TouchPAD sur le PCB, au profit d'un simple connecteur header 2.54 ==> Permettra le raccordement directement des modules chinois
    - Modification de la librairie du connecteur USB 47642.
    - Modification du footprint du connecteur USB 47642 afin de tenir compte de l'aspect "Throughole".
    [FrogINT_PCBProto_V1811062154.kicad_pcb, FrogINT_PCBProto_V1811062154.sch]
2019-03-26 Commit du 26/03/2019 en vue de la Release V2.
    Décision de figer une release V2 avant de modifier complètement le circuit et le PCB.
    [FrogINT_PCBProto_V1811062154.sch]
2019-03-26 Commit du 26/03/2019 :
    - Refonte du PCB --> passage en circulaire de 3,8mm de diamètre
    - Mise à jour des librairies avec notamment création de la librairie atmega16u4-au
    - Mise à jour de la librairie sur le connecteur USB pour ajouter les CTRL.YBCK -> limite du composant
    - Suppression de la fonction d'alimention 3V3 au profit d'une seule alimentation en 5V. Attention, il faut cependant corriger le naming
    - Changement du connecteur pour le TouchSensor (femelle)
    - ajout d'un R/C + pad pour souder directement une antenne pour tester le Sensor Capacitif
    - suppression du bouton reset et du bouton interrupt.
    [FrogINT_BOM_V03.xlsx, FrogINT_PCBProto_V1811062154.kicad_pcb, FrogINT_PCBProto_V1811062154.sch]
2019-04-02 Evolution de la V3 :
    + Creation d'un modèle pour les LED WS2812 avec HeatSink (Footprint + meca3D)
    + Creation d'un modèle pour Fusible (Footprint + Meca3D)
    Autre évolution majeure :
    • Ligne USB – Faire une paire différentielle
    • Supprimer le switch « normal » pour ne conserver que le switch « reset ».
    o OK
    • Mais router en externe une GPIO
    o OK mutualisé avec R/C pour Touche sensor
    • Suppression du TouchPad au profit d’un connecteur 2.54 coudé – femelle. ATTENTION actuellement de type mâle à remplacer à femelle.
    o OK
    o Genre du header à remplacer de mâle à femelle
    • Ajouter R & C pour tester le TouchPanel avec une feuille d’alu.
    o OK mutualisé avec R/C p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
    [FrogINT_BOM_V03.xlsx, FrogINT_PCBProto_V1811062154-B_Cu.dxf, FrogINT_PCBProto_V1811062154-B_Mask.dxf, FrogINT_PCBProto_V1811062154-B_Paste.dxf, FrogINT_PCBProto_V1811062154-B_SilkS.dxf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]
